Afr0-d1t3/MockDVC/README.md

# MockDVC
Project to create a digital valve controller using a Time-of-Flight sensor, actuator, I/P, and STM microcontroller
