Afr0-d1t3/MockDVC/LTSpice Circuits/4_20mA_Circuit.asc

D1: zener; TDZV6_8
D2: zener; TDZV6_8
D3: zener; TDZV6_8
D4: diode
D5: diode
D6: diode
R1: res; 1K
R2: res; 1.5k
R5: res; 143
U1: UniversalOpAmp
V1: voltage; SINE(1.65 1.65 1)
V2: voltage; 10
Named nets: 0
.tran 1
