Afr0-d1t3/MockDVC/LTSpice Circuits/OP_AMP.asc

R1: res; 1K
R2: res; 1k
R3: res; 330
U1: UniversalOpAmp
V1: voltage; SINE(1.65 1.65 1)
V2: voltage; 10
Named nets: 0
.tran 1
