Afr0-d1t3/MockDVC/(commit log)

2024-05-15 Added the main and TOF files
    Must enable ADCs and DACs correctly. Purpose of TOF file is to work independently of STM32CubeIDE.
2024-05-15 Whole Project Upload
    [SuperLoop BOM.xlsx, Superloop_Calculations.xlsx]
